pristinesource/0ZeroRobotControl/pics/PiPrinter005.png

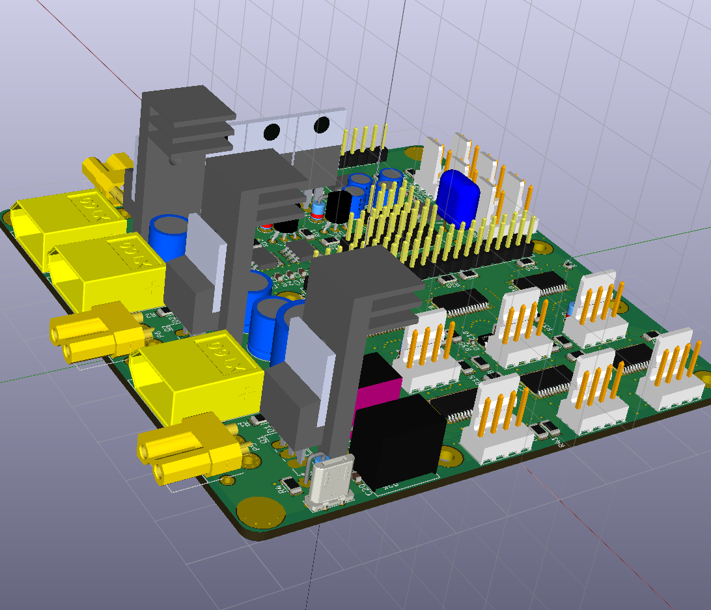
pics/PiPrinter005.png
