pristinesource/0ZeroRobotControl/pics/PiPrinter001.png

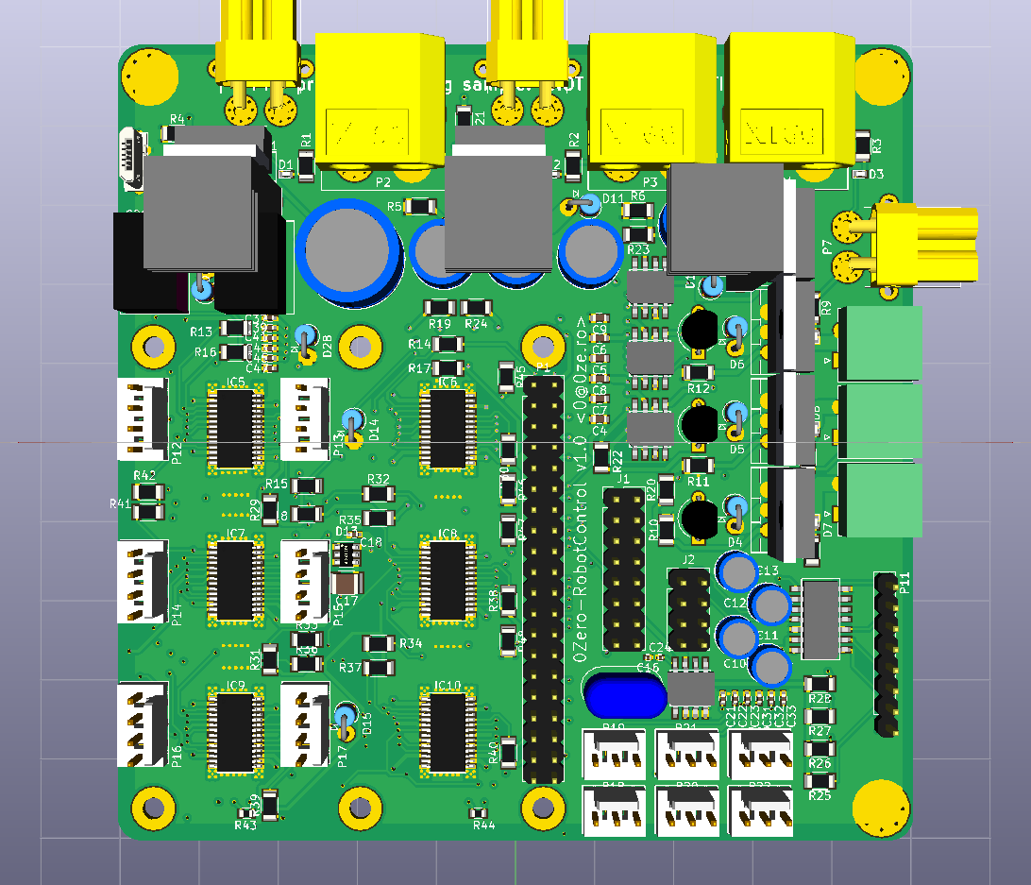
pics/PiPrinter001.png
