pristinesource/0ZeroRobotControl/0ZeroRobotControl_BOM.xlsx

Title
Revision
Date
Generated | 2017-03-08 17:09
Company
Comment 1
Comment 2
Comment 3
Comment 4
Total Parts | 155
Total Unique Parts | 56
Ref | Qty | Value | Footprint | Price per 1 |  | Price per 1000 |  | Digi-key Product Link | Alt Product Link
C2 C3 C14 C15 | 4 | 100uF | Capacitors_THT:CP_Radial_D8.0mm_P3.50mm | $0.58 | $2.32 | $148.24 | $592.96 | http://www.digikey.com/short/329c5t | http://www.digikey.com/short/329c58
C4 C5 C6 C9 C8 C7 C20 | 7 | .1uF | Capacitors_SMD:C_0603 | $0.10 | $0.70 | $6.24 | $43.68 | http://www.digikey.com/short/329cw3
C10 C11 C12 C13 | 4 | 10uF | Capacitors_THT:CP_Radial_D5.0mm_P2.00mm | $0.26 | $1.04 | $53.82 | $215.28 | http://www.digikey.com/short/329c11
C1 | 1 | 680 uF | Capacitors_THT:CP_Radial_D12.5mm_P5.00mm | $1.31 | $1.31 | $518.10 | $518.10 | http://www.digikey.com/short/329c0t
C37 C39 C41 C43 C45 C47 C17 C18 C19 C28 C29 C30 | 12 | 220 nF | Capacitors_SMD:C_0402 | $0.22 | $2.64 | $46.76 | $561.12 | http://www.digikey.com/short/32bp2q
C25 C21 C26 C22 C27 C23 C34 C31 C35 C32 C36 C33 | 12 | 10 nF | Capacitors_SMD:C_0402 | $0.10 | $1.20 | $7.03 | $84.36 | http://www.digikey.com/short/32bpwm
C16 C24 | 2 | 27 pF | Capacitors_SMD:C_0201 | $0.10 | $0.20 | $3.64 | $7.28 | http://www.digikey.com/short/32bpnm
D2 | 1 | LED2 | LEDs:LED_0402 | $0.42 | $0.42 | $110.88 | $110.88 | http://www.digikey.com/short/32bpv5 | Red
D1 | 1 | LED1 | LEDs:LED_0402 | $0.42 | $0.42 | $110.88 | $110.88 | http://www.digikey.com/short/32bpv5 | Red
D3 | 1 | LED3 | LEDs:LED_0402 | $0.42 | $0.42 | $110.88 | $110.88 | http://www.digikey.com/short/32bpv5 | Red
D8 | 1 | LED5 | LEDs:LED_0402 | $0.42 | $0.42 | $110.88 | $110.88 | http://www.digikey.com/short/32bp1q | Yellow
D7 | 1 | LED4 | LEDs:LED_0402 | $0.42 | $0.42 | $110.88 | $110.88 | http://www.digikey.com/short/32bp1q | Yellow
D9 | 1 | LED6 | LEDs:LED_0402 | $0.42 | $0.42 | $110.88 | $110.88 | http://www.digikey.com/short/32bp1q | Yellow
D4 D5 D6 D10 D11 D12 D21 D24 | 8 | SB340 | Diodes_THT:D_T-1_P2.54mm_Vertical_AnodeUp | $0.44 | $3.52 | $222.54 | $1780.32 | http://www.digikey.com/short/32bzc8
D20 D22 D23 D25 D26 D27 | 6 | BAV99 | TO_SOT_Packages_SMD:SOT-23 | $0.21 | $1.26 | $39.14 | $234.84 | http://www.digikey.com/short/32bzcn
D28 | 1 | 3.3V-3W | Diodes_THT:D_T-1_P2.54mm_Vertical_AnodeUp | $0.36 | $0.36 | $111.24 | $111.24 | http://www.digikey.com/short/32bz7r
IC1 IC2 IC3 | 3 | TC4427A | SMD_Packages:SOIC-8-N | $1.17 | $3.51 | $885.80 | $2657.40 | http://www.digikey.com/short/32bztp
IC5 IC6 IC7 IC8 IC9 IC10 | 6 | L6470 | Housings_SSOP:HTSSOP-28_4.4x9.7mm_Pitch0.65mm_ThermalPad | $7.72 | $46.32 | $4378.05 | $26268.30 | http://www.digikey.com/short/32bz30
IC4 | 1 | CY25811 | SMD_Packages:SOIC-8-N | $2.20 | $2.20 | $1123.38 | $1123.38 | http://www.digikey.com/short/32bz84
J1 | 1 | CONN_02X08 | Pin_Headers:Pin_Header_Straight_2x08_Pitch2.54mm | $0.61 | $0.61 | $313.01 | $313.01 | http://www.digikey.com/short/32bz59
J2 | 1 | CONN_02X03 | Pin_Headers:Pin_Header_Straight_2x04_Pitch2.54mm | $0.36 | $0.36 | $168.00 | $168.00 | http://www.digikey.com/short/32bzr0
P1 | 1 | RaspPi 40pin Conn | Pin_Headers:Pin_Header_Straight_2x20_Pitch2.54mm | $5.10 | $5.10 | $5100.00 | $5100.00 | http://www.digikey.com/short/32htp8 | http://www.digikey.com/short/32htzq
P8 P9 P10 | 3 | 5452027 | Connectors_Phoenix:PhoenixContact_MC-G_02x3.81mm_Angled | $0.76 | $2.28 | $534.60 | $1603.80 | http://www.digikey.com/short/32bz2h
P7 P6 P5 | 3 | XT30PW-F | PiPrinter:XT30PW-F2 | $1.00 | $3.00 | $1000.00 | $3000.00 | http://www.banggood.com/5Pairs-Amass-XT30PW-30A-Low-Temperature-Rise-Fire-Retardant-Plug-p-1075324.html | http://www.china-amass.com/ChanPinZhanShi_v212.html
P2 P3 P4 | 3 | XT60PW-M | PiPrinter:XT60PW | $0.80 | $2.40 | $800.00 | $2400.00 | http://www.banggood.com/5X-Amass-XT60PW-Plug-Connector-Male-Female-For-RC-Battery-p-1081485.html?rmmds=search | http://www.china-amass.com/ChanPinZhanShi_v219.html
P11 | 1 | Thermistor_Inputs | Pin_Headers:Pin_Header_Straight_1x08_Pitch2.54mm | $0.26 | $0.26 | $131.29 | $131.29 | http://www.digikey.com/short/32b4c3
P18 | 1 | SW1 | Connectors_Molex:Molex_KK-6410-03_03x2.54mm_Straight | $0.35 | $0.35 | $167.13 | $167.13 | http://www.digikey.com/short/32bzv1
P19 | 1 | SW2 | Connectors_Molex:Molex_KK-6410-03_03x2.54mm_Straight | $0.35 | $0.35 | $167.13 | $167.13 | http://www.digikey.com/short/32bzv1
P20 | 1 | SW3 | Connectors_Molex:Molex_KK-6410-03_03x2.54mm_Straight | $0.35 | $0.35 | $167.13 | $167.13 | http://www.digikey.com/short/32bzv1
P21 | 1 | SW4 | Connectors_Molex:Molex_KK-6410-03_03x2.54mm_Straight | $0.35 | $0.35 | $167.13 | $167.13 | http://www.digikey.com/short/32bzv1
P22 | 1 | SW5 | Connectors_Molex:Molex_KK-6410-03_03x2.54mm_Straight | $0.35 | $0.35 | $167.13 | $167.13 | http://www.digikey.com/short/32bzv1
P23 | 1 | SW6 | Connectors_Molex:Molex_KK-6410-03_03x2.54mm_Straight | $0.35 | $0.35 | $167.13 | $167.13 | http://www.digikey.com/short/32bzv1
P25 P26 | 2 | CONN_01X01 | Pin_Headers:Pin_Header_Straight_1x01_Pitch2.54mm | $0.10 | $0.20 | $27.95 | $55.90 | http://www.digikey.com/short/32b47r
P12 | 1 | MOTOR-1 | Connectors_Molex:Molex_KK-6410-04_04x2.54mm_Straight | $0.39 | $0.39 | $182.35 | $182.35 | http://www.digikey.com/short/32b43q
P13 | 1 | MOTOR-2 | Connectors_Molex:Molex_KK-6410-04_04x2.54mm_Straight | $0.39 | $0.39 | $182.35 | $182.35 | http://www.digikey.com/short/32b43q
P14 | 1 | MOTOR-3 | Connectors_Molex:Molex_KK-6410-04_04x2.54mm_Straight | $0.39 | $0.39 | $182.35 | $182.35 | http://www.digikey.com/short/32b43q
P15 | 1 | MOTOR-4 | Connectors_Molex:Molex_KK-6410-04_04x2.54mm_Straight | $0.39 | $0.39 | $182.35 | $182.35 | http://www.digikey.com/short/32b43q
P16 | 1 | MOTOR-5 | Connectors_Molex:Molex_KK-6410-04_04x2.54mm_Straight | $0.39 | $0.39 | $182.35 | $182.35 | http://www.digikey.com/short/32b43q
P17 | 1 | MOTOR-6 | Connectors_Molex:Molex_KK-6410-04_04x2.54mm_Straight | $0.39 | $0.39 | $182.35 | $182.35 | http://www.digikey.com/short/32b43q
Q2 Q1 Q3 | 3 | AOT240L | TO_SOT_Packages_THT:TO-220_Neutral123_Vertical_LargePads | $1.63 | $4.89 | $761.25 | $2283.75 | http://www.digikey.com/short/32b48t
Q5 Q4 Q6 | 3 | AOT2618L | TO_SOT_Packages_THT:TO-220_Neutral123_Vertical_LargePads | $0.95 | $2.85 | $405.00 | $1215.00 | http://www.digikey.com/short/32b48z
R2 R1 R3 R8 R7 R9 | 6 | 8.2K | Resistors_SMD:R_1206 | $0.10 | $0.60 | $19.80 | $118.80 | http://www.digikey.com/short/32b4bc
R5 R4 R6 R11 R10 R12 | 6 | 10K | Resistors_SMD:R_1206 | $0.10 | $0.60 | $9.04 | $54.24 | http://www.digikey.com/short/32b4bd
R19 R20 R21 R22 R23 R24 | 6 | 22R | Resistors_SMD:R_1206 | $0.14 | $0.84 | $19.80 | $118.80 | http://www.digikey.com/short/32b45n
R25 R26 R27 R28 | 4 | 4.7K | Resistors_SMD:R_1206 | $0.14 | $0.56 | $19.80 | $79.20 | http://www.digikey.com/short/32b4r5
R13 R14 R15 R32 R33 R34 | 6 | 100R | Resistors_SMD:R_1206 | $0.10 | $0.60 | $9.08 | $54.48 | http://www.digikey.com/short/32b4f7
R29 R16 R30 R17 R31 R18 R38 R35 R39 R36 R40 R37 | 12 | 39K | Resistors_SMD:R_1206 | $0.14 | $1.68 | $19.80 | $237.60 | http://www.digikey.com/short/32b4f2
R41 | 1 | 36K | Resistors_SMD:R_1206 | $0.14 | $0.14 | $19.80 | $19.80 | http://www.digikey.com/short/32b4wc
R42 | 1 | 2.7K | Resistors_SMD:R_1206 | $0.14 | $0.14 | $19.80 | $19.80 | http://www.digikey.com/short/32b4ww
U1 U2 U3 | 3 | LM78L12ACZ | TO_SOT_Packages_THT:TO-92_Inline_Wide | $0.44 | $1.32 | $109.60 | $328.80 | http://www.digikey.com/short/32b4hm
U8 | 1 | R-78E5.0-1.0 | PiPrinter:R-78E5.0-1.0 | $3.62 | $3.62 | $2898.00 | $2898.00 | http://www.digikey.com/short/32b4mr
U7 | 1 | R-78E3.3-1.0 | PiPrinter:R-78E3.3-1.0 | $3.62 | $3.62 | $2898.00 | $2898.00 | http://www.digikey.com/short/32b4m3
U4 | 1 | MCP3204 | SMD_Packages:SOIC-14_N | $3.27 | $3.27 | $2472.00 | $2472.00 | http://www.digikey.com/short/32b44z
Y1 | 1 | Crystal 32MHz | Crystals:Resonator-2pin_w10.0mm_h5.0mm | $0.39 | $0.39 | $208.00 | $208.00 | http://www.digikey.com/short/32b4pf
 | 3 | TO-220 Heatsink | CSM221-12AE-ND | $0.63 | $1.89 | $435.00 | $1305.00 | http://www.digikey.com/short/329jp4
 | 1 | USB Micro-B Plug | USB3150-30-075-A | $0.99 | $0.99 | $485.00 | $485.00 | http://www.newark.com/global-connector-technology/usb3150-30-075-a/micro-usb-2-0-type-b-plug-th/dp/49Y1722
 | 159 |  | TOTALS: | $47.26 | $115.75 | $29189.76 | $64528.69
BOM made with KICAD_BOM_WIZARD (https://github.com/HashDefineElectronics/KiCad_BOM_Wizard.git)
Generated 3/8/2017 5:09:55 PM |  |  |  | PCBs | 60 | http://dirtypcbs.com/store/pcbs
 |  |  |  | Stencil | 50 | http://www.stencilsunlimited.com/stainless-steel-smt-stencil-p-727.html
 |  |  |  | solder paste | 50 | http://www.stencilsunlimited.com/nc676-no-clean-solder-paste-p-599.html
 |  |  |  | squegee | 10 | http://www.stencilsunlimited.com/prototype-squeegee-blade-p-79.html
