pristinesource/0ZeroRobotControl/BOM.xlsx

description | part group | preferred part number | alt part number | product page | qty req | extended desc.
MOSFET Driver | MOSFET Power | TC4427AEPA | TC4427ACPA | http://www.digikey.com/product-detail/en/microchip-technology/TC4427AEPA/TC4427AEPA-ND/442808 http://www.digikey.com/product-detail/en/microchip-technology/TC4427ACPA/TC4427ACPA-ND/418665 | 3
Large MOSFET | MOSFET Power | AOT240L |  | http://www.digikey.com/short/3f8954 | 3
Small MOSFET | MOSFET Power | AOT2618L |  | http://www.digikey.com/short/3f82zp | 3
to-220 mosfet heatsinks | MOSFET Power | 574502B03700G | 574602B03700G | http://www.digikey.com/product-detail/en/aavid-thermalloy/574502B03700G/HS358-ND/1216363 http://www.digikey.com/product-detail/en/aavid-thermalloy/574602B03700G/HS359-ND/1216364 | 6
external power input | MOSFET Power | XT60PW-M |  |  | 3
external power outputs for big MOSFETS | MOSFET Power | XT30PW-F |  |  | 3
external power outputs for small MOSFETS | MOSFET Power | 5452027 - Phoenix Contact |  | http://www.digikey.com/short/3fjc2b http://www.digikey.com/short/3fjcnt http://www.digikey.com/short/3fjc0b http://www.digikey.com/short/328311 | 3 | 2 Position Terminal Block Header, Male Pins, Shrouded (4 Side) 0.150" (3.81mm) 90°, Right Angle Through Hole
12v power regulator for MOSFET driver | MOSFET Power | LM78L12ACZX |  | http://www.digikey.com/short/3f8b79 | 3
Resistors 10K | MOSFET Power | 10K |  |  | 12
Resistors 8.2K | MOSFET Power | 8.2k |  |  | 6
Resistors 22R | MOSFET Power | 22R |  |  | 6
Status LEDs | MOSFET Power | not sure yet |  |  | 6 | 3 one color for small, and 3 a diff color for lrg
Polarized Cpacitors | MOSFET Power | 100uF |  |  | 3
Non-Polorized Cpacitors | MOSFET Power | .1uF |  |  | 6
Diodes for small MOSFET flyback | MOSFET Power | SB340 |  | http://www.digikey.com/short/3fjrjm | 6
ADC | Temp ctrl | MCP3204-CI/P | https://www.adafruit.com/product/1083 | http://www.digikey.com/short/3fjn17 | 1 | https://learn.adafruit.com/reading-a-analog-in-and-controlling-audio-volume-with-the-raspberry-pi
Endstop Connectors | Endstops | WM10158-ND | 1718570003 - Molex | http://www.digikey.com/short/3fj07m | 6 | 3 Positions Header Connector 0.100" (2.54mm) Through Hole, Right Angle Tin
Stepper motor connectors | Steppers | WM10159-ND | 1718570004 - Molex | http://www.digikey.com/short/3fj03r | 5
 |  | IO Expander | MCP23S08-E/P-ND | MCP23S08-E/P | 1 | I/O Expander 8 SPI 10MHz 18-PDIP | https://learn.adafruit.com/mcp230xx-gpio-expander-on-the-raspberry-pi/overview
