pristinesource/0ZeroRobotControl/pics/PiPrinter002.png

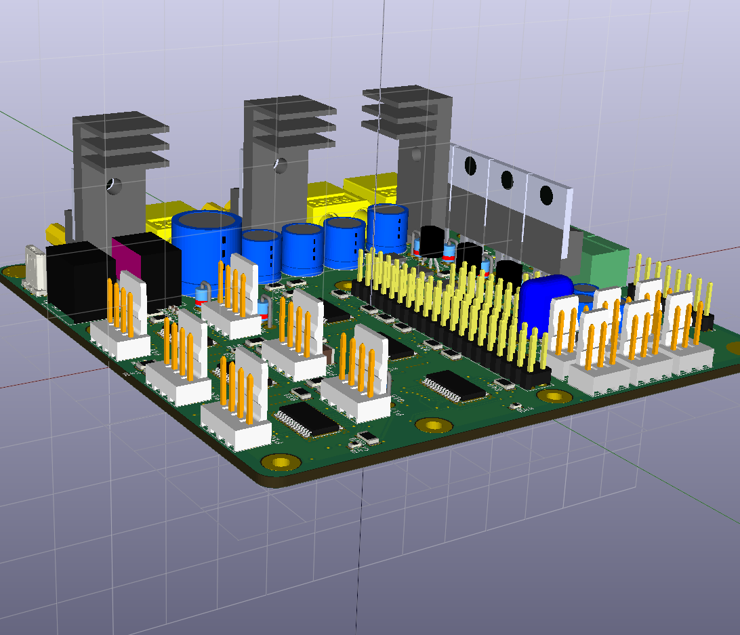
pics/PiPrinter002.png
