pristinesource/0ZeroRobotControl/pics/PiPrinter003.png

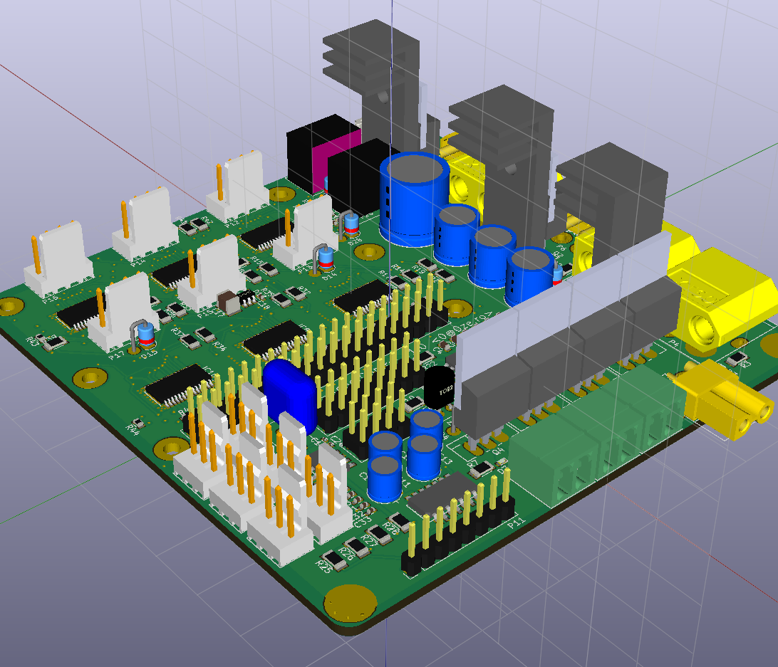
pics/PiPrinter003.png
