pristinesource/0ZeroRobotControl/pics/PiPrinter004.png

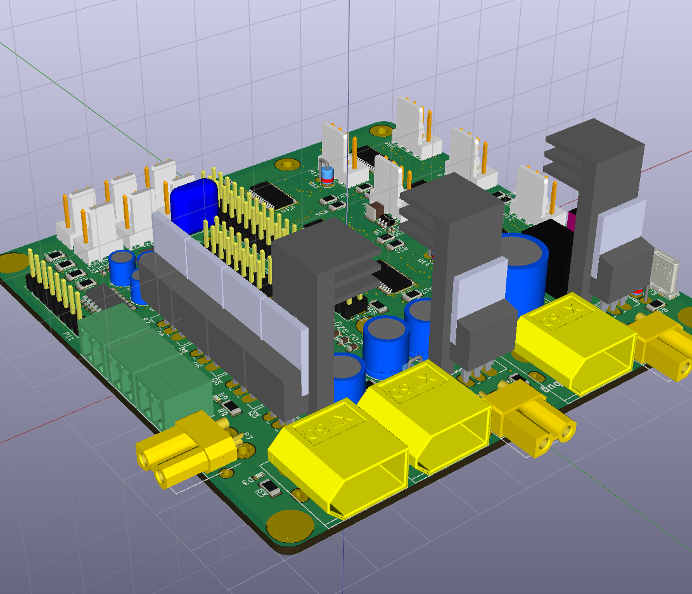
pics/PiPrinter004.png
