pristinesource/0ZeroRobotControl/pics/PiPrinter006.png

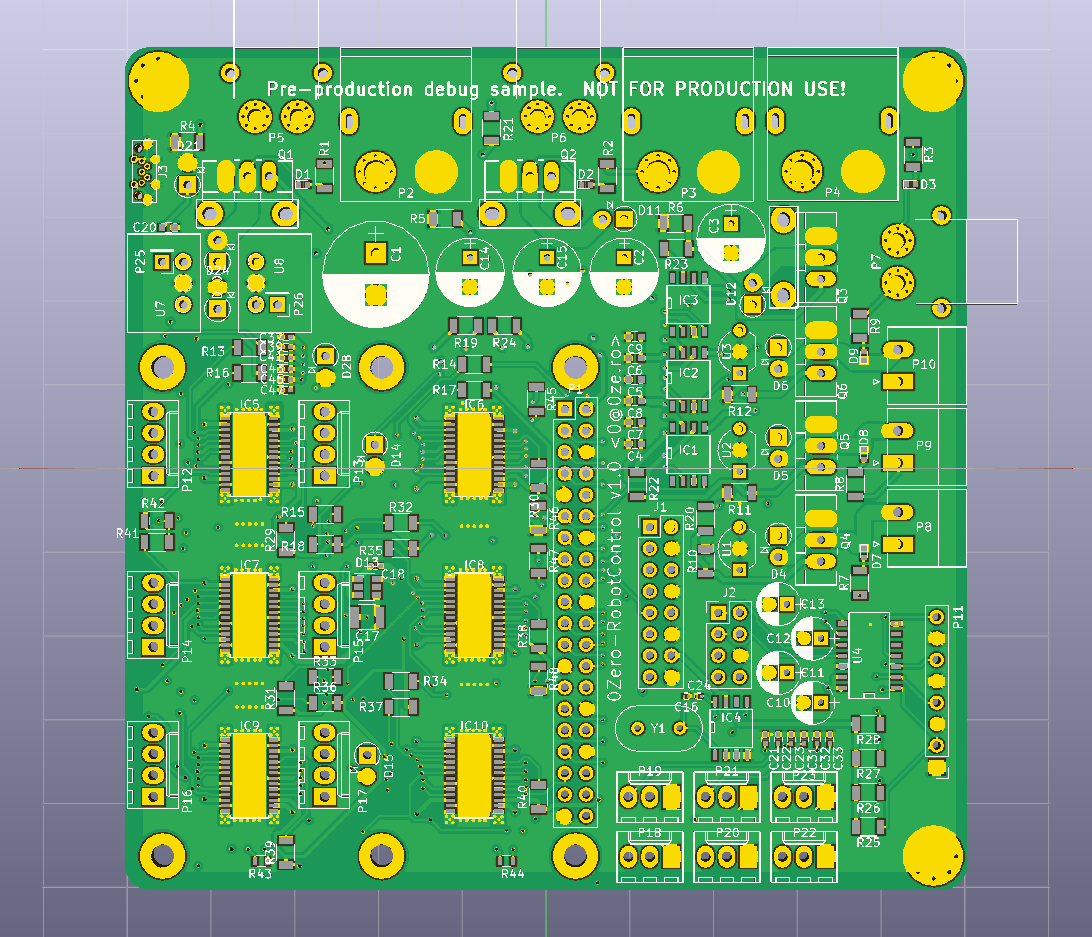
pics/PiPrinter006.png
