pristinesource/0ZeroRobotControl/(list of files, drawings)

Other design files:
0ZeroRobotControl.dsn
