pristinesource/0ZeroRobotControl/0ZeroRobotControl.sch

## KiCad design 0ZeroRobotControl.sch (2017-04-07)

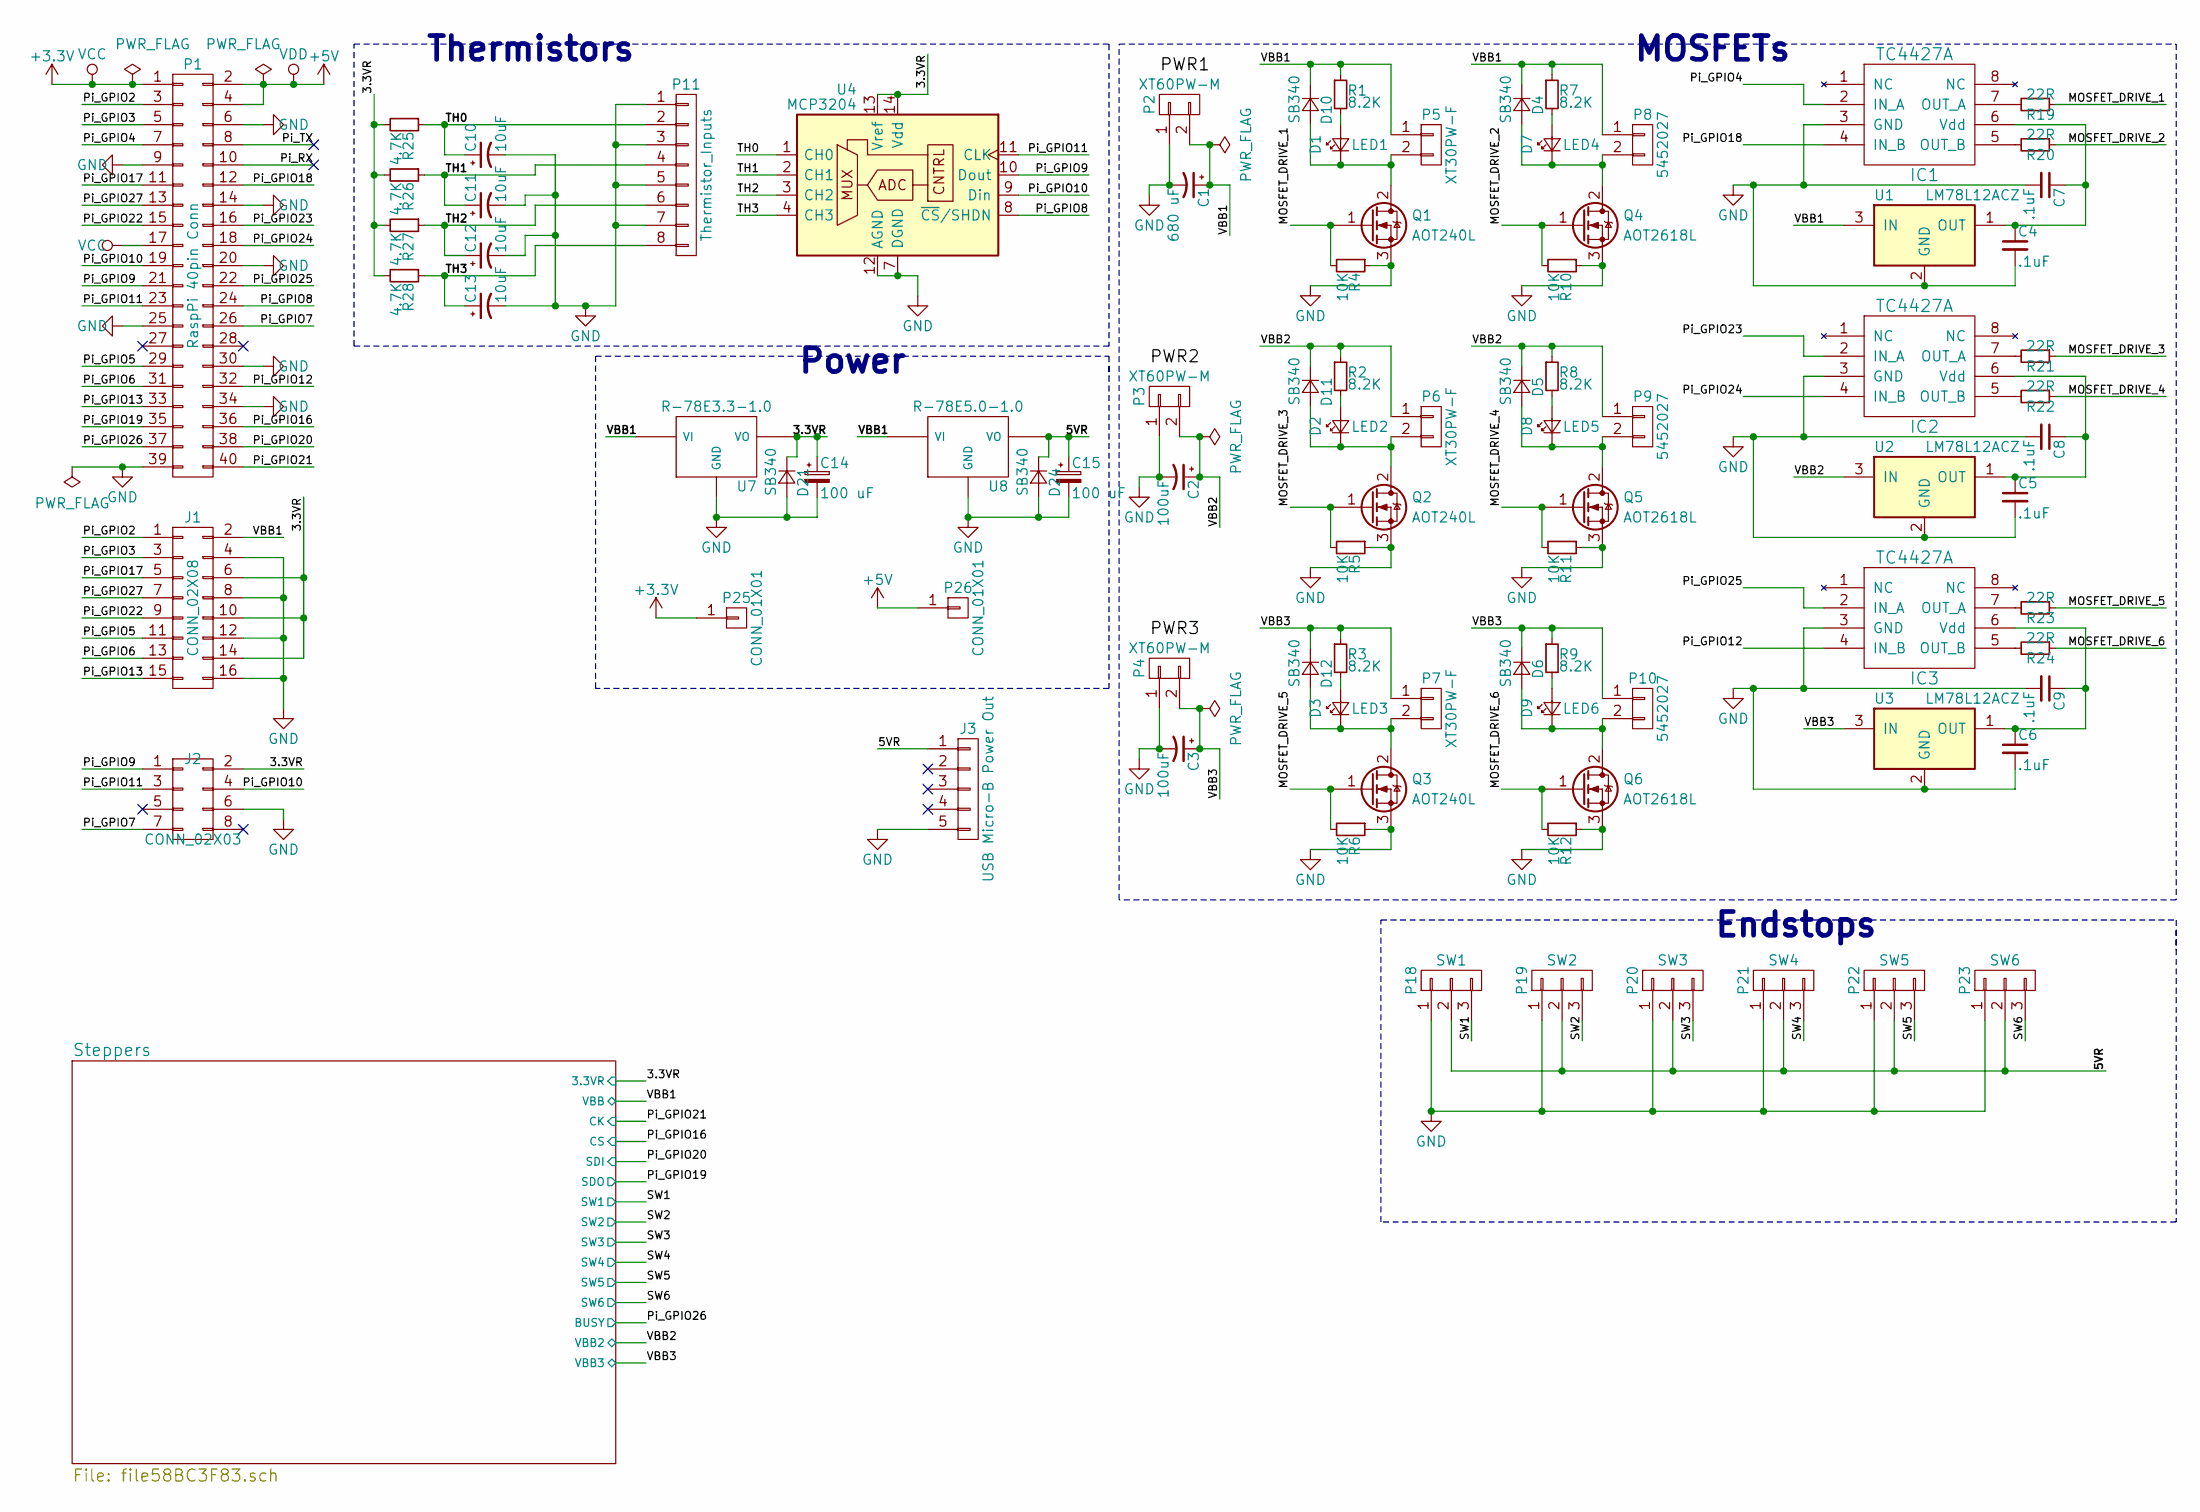
[picture p7: schematic 0ZeroRobotControl.sch]

Parts:
C1: 680 uF; CP_Radial_D12.5mm_P5.00mm
C2, C3: 100uF; CP_Radial_D8.0mm_P3.50mm
C4, C5, C6, C7, C8, C9: .1uF; C_0603
C10, C11, C12, C13: 10uF; CP_Radial_D5.0mm_P2.00mm
C14, C15: 100 uF; CP_Radial_D8.0mm_P3.50mm
D1: LED1; LED_0402
D2: LED2; LED_0402
D3: LED3; LED_0402
D4, D5, D6, D10, D11, D12, D21, D24: SB340; D_T-1_P2.54mm_Vertical_AnodeUp
D7: LED4; LED_0402
D8: LED5; LED_0402
D9: LED6; LED_0402
IC1, IC2, IC3: TC4427A; SOIC-8-N
J1: CONN_02X08; Pin_Header_Straight_2x08_Pitch2.54mm
J2: CONN_02X03; Pin_Header_Straight_2x04_Pitch2.54mm
J3: USB Micro-B Power Out; USB3150-30-075-A
P1: RaspPi 40pin Conn; Pin_Header_Straight_2x20_Pitch2.54mm
P2, P3, P4: XT60PW-M; XT60PW
P5, P6, P7: XT30PW-F; XT30PW-F2
P8, P9, P10: 5452027; PhoenixContact_MC-G_02x3.81mm_Angled
P11: Thermistor_Inputs; Pin_Header_Straight_1x08_Pitch2.54mm
P18: SW1; Molex_KK-6410-03_03x2.54mm_Straight
P19: SW2; Molex_KK-6410-03_03x2.54mm_Straight
P20: SW3; Molex_KK-6410-03_03x2.54mm_Straight
P21: SW4; Molex_KK-6410-03_03x2.54mm_Straight
P22: SW5; Molex_KK-6410-03_03x2.54mm_Straight
P23: SW6; Molex_KK-6410-03_03x2.54mm_Straight
P25, P26: CONN_01X01; Pin_Header_Straight_1x01_Pitch2.54mm
Q1, Q2, Q3: AOT240L; TO-220_Neutral123_Vertical_LargePads_plus_ohmite_heatsink
Q4, Q5, Q6: AOT2618L; TO-220_Neutral123_Vertical_LargePads
R1, R2, R3, R7, R8, R9: 8.2K; R_1206
R4, R5, R6, R10, R11, R12: 10K; R_1206
R19, R20, R21, R22, R23, R24: 22R; R_1206
R25, R26, R27, R28: 4.7K; R_1206
U1, U2, U3: LM78L12ACZ; TO-92_Inline_Wide
U4: MCP3204; SOIC-14_N
U7: R-78E3.3-1.0
U8: R-78E5.0-1.0

Connections:
3.3VR: C14.1, D21.1 (K), J1.6, J1.10, J1.14, J2.2, R25.2, R26.2, R27.2, R28.2, U4.13 (Vref), U4.14 (Vdd), U7.VO
5VR: C15.1, D24.1 (K), J3.1, P18.2, P19.2, P20.2, P21.2, P22.2, P23.2, U8.VO
+3.3V: P1.1, P1.17, P25.1
+5V: P1.2, P1.4, P26.1
GND: C1.2, C2.2, C3.2, C4.2, C5.2, C6.2, C7.2, C8.2, C9.2, C10.2, C11.2, C12.2, C13.2, C14.2, C15.2, D21.2 (A), D24.2 (A), IC1.3 (GND), IC2.3 (GND), IC3.3 (GND), J1.4, J1.8, J1.12, J1.16, J2.6, J3.5, P1.6, P1.9, P1.14, P1.20, P1.25, P1.30, P1.34, P1.39, P2.1, P3.1, P4.1, P11.1, P11.3, P11.5, P11.7, P18.1, P19.1, P20.1, P21.1, P22.1, P23.1, Q1.3 (S), Q2.3 (S), Q3.3 (S), Q4.3 (S), Q5.3 (S), Q6.3 (S), R4.1, R5.1, R6.1, R10.1, R11.1, R12.1, U1.2 (GND), U2.2 (GND), U3.2 (GND), U4.7 (DGND), U4.12 (AGND), U7.GND, U8.GND
MOSFET_DRIVE_1: Q1.1 (G), R4.2, R19.1
MOSFET_DRIVE_2: Q4.1 (G), R10.2, R20.1
MOSFET_DRIVE_3: Q2.1 (G), R5.2, R21.1
MOSFET_DRIVE_4: Q5.1 (G), R11.2, R22.1
MOSFET_DRIVE_5: Q3.1 (G), R6.2, R23.1
MOSFET_DRIVE_6: Q6.1 (G), R12.2, R24.1
unnamed: C4.1, C7.1, IC1.6 (Vdd), U1.1 (OUT)
unnamed: C5.1, C8.1, IC2.6 (Vdd), U2.1 (OUT)
unnamed: C6.1, C9.1, IC3.6 (Vdd), U3.1 (OUT)
unnamed: D1.1 (K), D10.2 (A), P5.2, Q1.2 (D)
unnamed: D1.2 (A), R1.2
unnamed: D2.2 (A), R2.2
unnamed: D3.2 (A), R3.2
unnamed: D4.2 (A), D7.1 (K), P8.2, Q4.2 (D)
unnamed: D5.2 (A), D8.1 (K), P9.2, Q5.2 (D)
unnamed: D6.2 (A), D9.1 (K), P10.2, Q6.2 (D)
unnamed: D7.2 (A), R7.2
unnamed: D8.2 (A), R8.2
unnamed: D9.2 (A), R9.2
unnamed: D2.1 (K), D11.2 (A), P6.2, Q2.2 (D)
unnamed: D3.1 (K), D12.2 (A), P7.2, Q3.2 (D)
unnamed: IC1.5 (OUT_B), R20.2
unnamed: IC1.7 (OUT_A), R19.2
unnamed: IC2.5 (OUT_B), R22.2
unnamed: IC2.7 (OUT_A), R21.2
unnamed: IC3.5 (OUT_B), R24.2
unnamed: IC3.7 (OUT_A), R23.2
Pi_GPIO2: J1.1, P1.3
Pi_GPIO3: J1.3, P1.5
Pi_GPIO4: IC1.2 (IN_A), P1.7
Pi_GPIO5: J1.11, P1.29
Pi_GPIO6: J1.13, P1.31
Pi_GPIO7: J2.7, P1.26
Pi_GPIO8: P1.24, U4.8 (~CS~/SHDN)
Pi_GPIO9: J2.1, P1.21, U4.10 (Dout)
Pi_GPIO10: J2.4, P1.19, U4.9 (Din)
Pi_GPIO11: J2.3, P1.23, U4.11 (CLK)
Pi_GPIO12: IC3.4 (IN_B), P1.32
Pi_GPIO13: J1.15, P1.33
Pi_GPIO16: P1.36
Pi_GPIO17: J1.5, P1.11
Pi_GPIO18: IC1.4 (IN_B), P1.12
Pi_GPIO19: P1.35
Pi_GPIO20: P1.38
Pi_GPIO21: P1.40
Pi_GPIO22: J1.9, P1.15
Pi_GPIO23: IC2.2 (IN_A), P1.16
Pi_GPIO24: IC2.4 (IN_B), P1.18
Pi_GPIO25: IC3.2 (IN_A), P1.22
Pi_GPIO26: P1.37
Pi_GPIO27: J1.7, P1.13
Pi_RX: P1.10
Pi_TX: P1.8
SW1: P18.3
SW2: P19.3
SW3: P20.3
SW4: P21.3
SW5: P22.3
SW6: P23.3
TH0: C10.1, P11.2, R25.1, U4.1 (CH0)
TH1: C11.1, P11.4, R26.1, U4.2 (CH1)
TH2: C12.1, P11.6, R27.1, U4.3 (CH2)
TH3: C13.1, P11.8, R28.1, U4.4 (CH3)
VBB1: C1.1, D4.1 (K), D10.1 (K), J1.2, P2.2, P5.1, P8.1, R1.1, R7.1, U1.3 (IN), U7.VI, U8.VI
VBB2: C2.1, D5.1 (K), D11.1 (K), P3.2, P6.1, P9.1, R2.1, R8.1, U2.3 (IN)
VBB3: C3.1, D6.1 (K), D12.1 (K), P4.2, P7.1, P10.1, R3.1, R9.1, U3.3 (IN)

Notes on the sheet:
MOSFETs
Thermistors
Endstops
Power
