pristinesource/0ZeroRobotControl/file58BC3F83.sch

## KiCad design file58BC3F83.sch (2017-04-07)

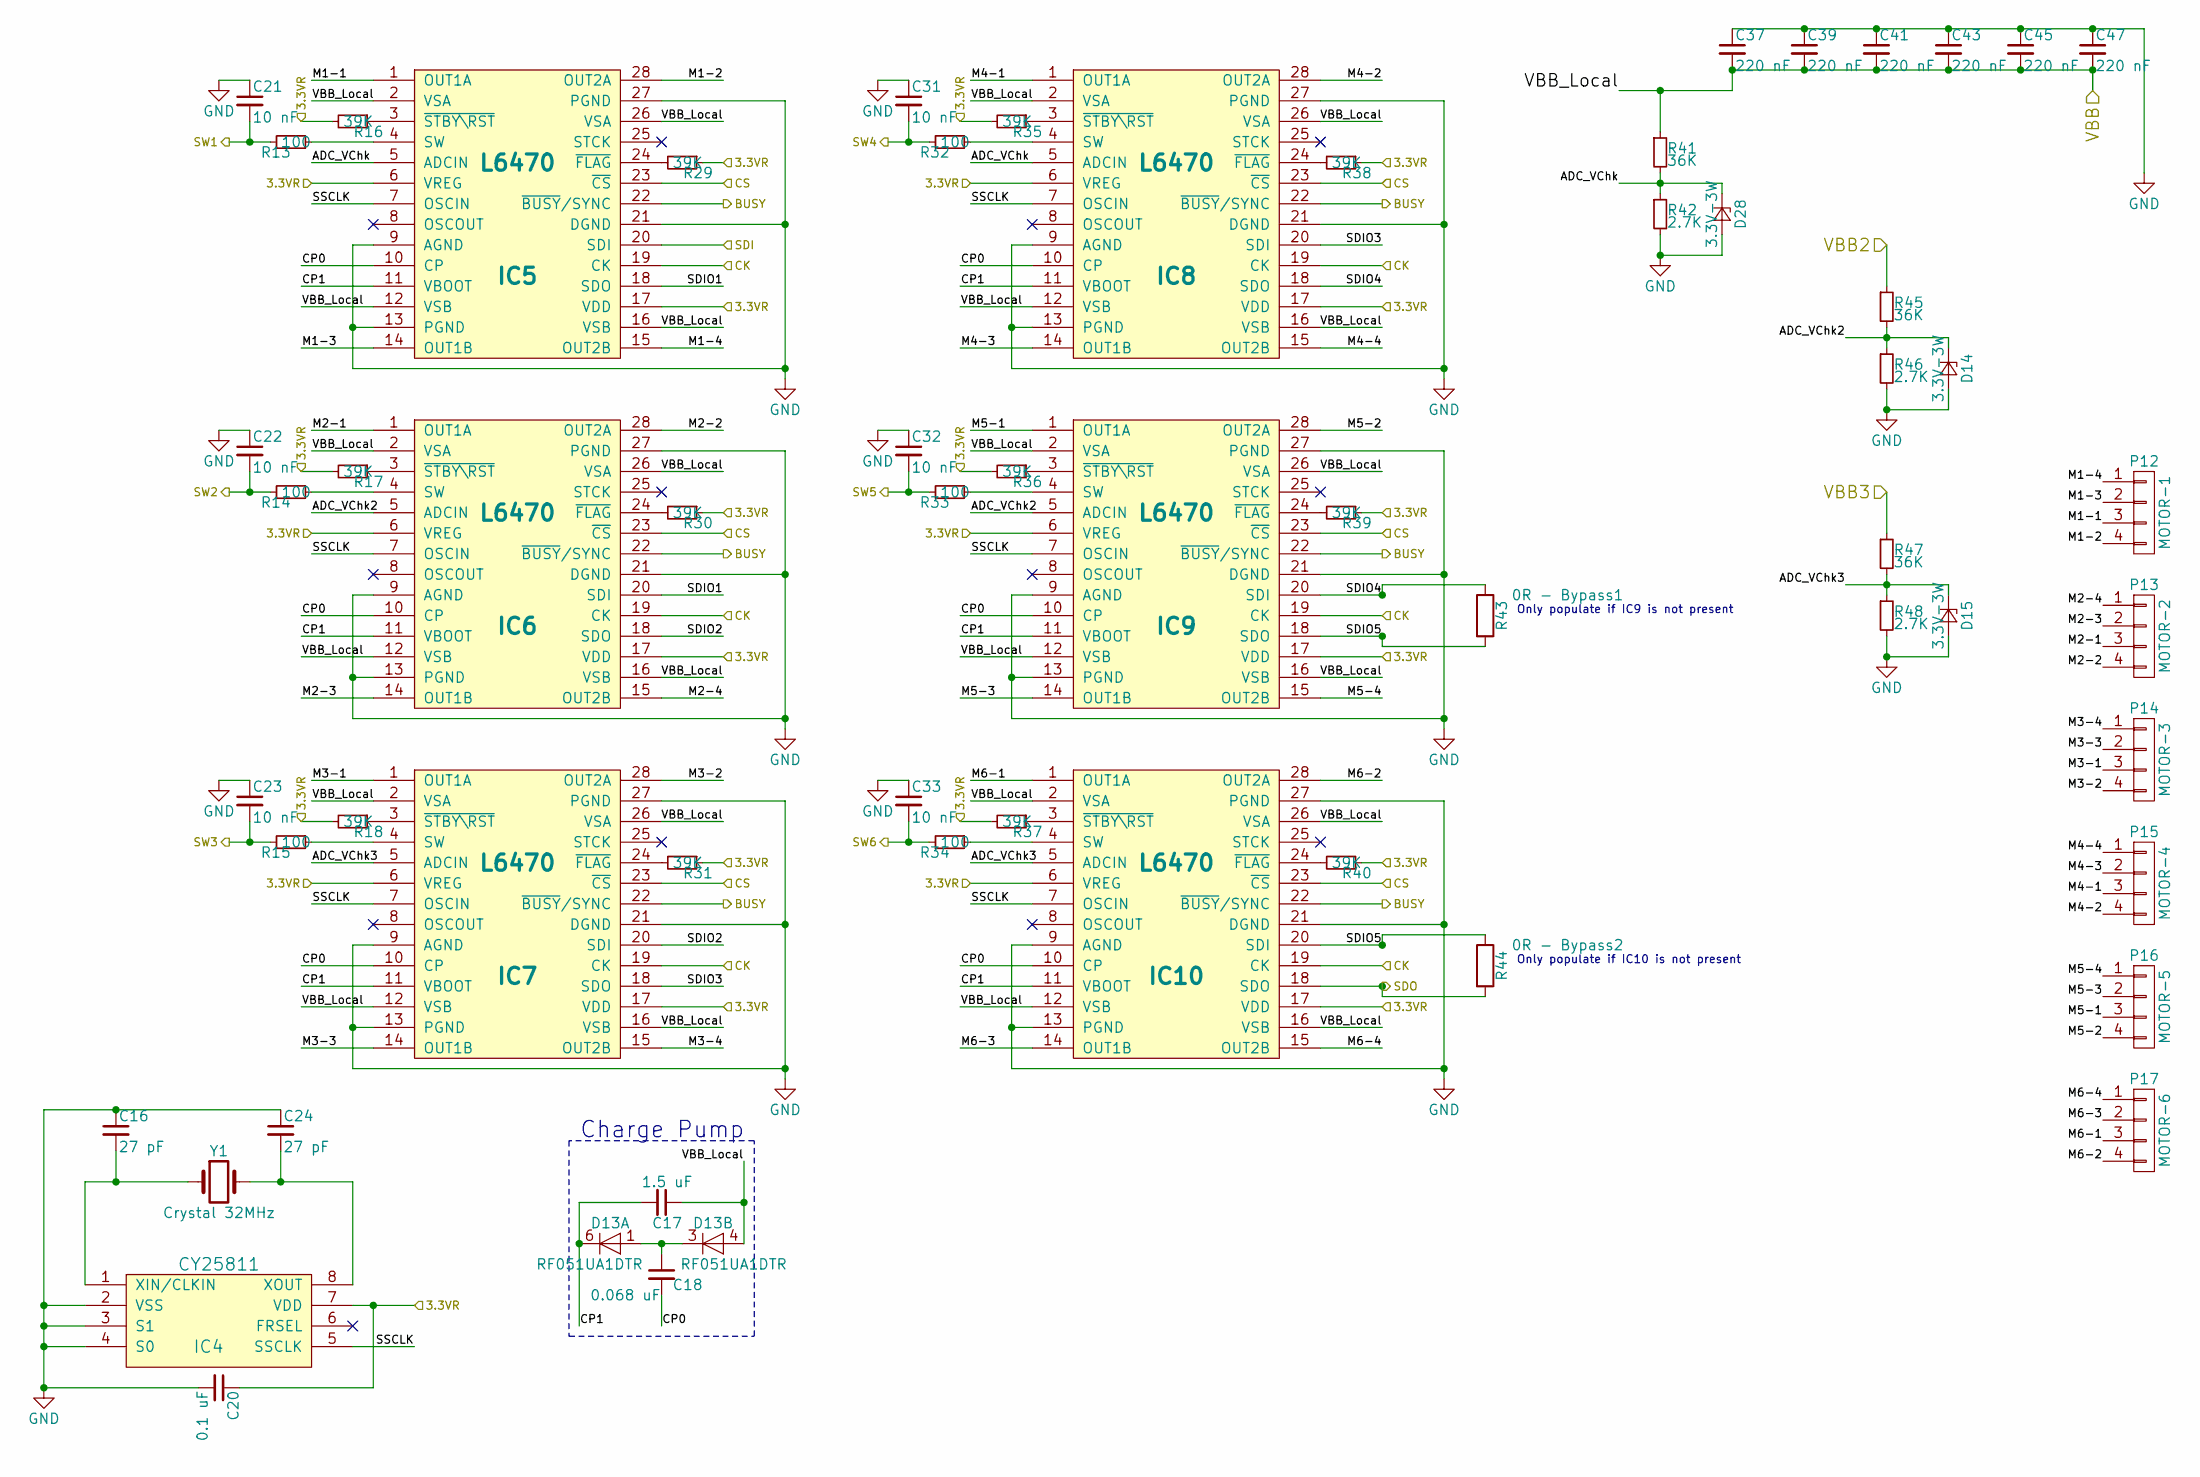
[picture p8: schematic file58BC3F83.sch]

Parts:
C16, C24: 27 pF; C_0201
C17: 1.5 uF; C_1210
C18: 0.068 uF; C_0402
C20: 0.1 uF; C_0603
C21, C22, C23, C31, C32, C33: 10 nF; C_0402
C37, C39, C41, C43, C45, C47: 220 nF; C_0402
D13: RF051UA1DTR; SOT-23-6
D14, D15, D28: 3.3V-3W; D_T-1_P2.54mm_Vertical_AnodeUp
IC4: CY25811; SOIC-8-N
IC5, IC6, IC7, IC8, IC9, IC10: L6470; HTSSOP-28_4.4x9.7mm_Pitch0.65mm_ThermalPad
P12: MOTOR-1; Molex_KK-6410-04_04x2.54mm_Straight
P13: MOTOR-2; Molex_KK-6410-04_04x2.54mm_Straight
P14: MOTOR-3; Molex_KK-6410-04_04x2.54mm_Straight
P15: MOTOR-4; Molex_KK-6410-04_04x2.54mm_Straight
P16: MOTOR-5; Molex_KK-6410-04_04x2.54mm_Straight
P17: MOTOR-6; Molex_KK-6410-04_04x2.54mm_Straight
R13, R14, R15, R32, R33, R34: 100; R_1206
R16, R17, R18, R29, R30, R31, R35, R36, R37, R38, R39, R40: 39K; R_1206
R41, R45, R47: 36K; R_1206
R42, R46, R48: 2.7K; R_1206
R43: 0R - Bypass1; R_0603
R44: 0R - Bypass2; R_0603
Y1: Crystal 32MHz; Resonator-2pin_w10.0mm_h5.0mm

Connections:
3.3VR: C20.1, IC4.7 (VDD), IC5.6 (VREG), IC5.17 (VDD), IC6.6 (VREG), IC6.17 (VDD), IC7.6 (VREG), IC7.17 (VDD), IC8.6 (VREG), IC8.17 (VDD), IC9.6 (VREG), IC9.17 (VDD), IC10.6 (VREG), IC10.17 (VDD), R16.2, R17.2, R18.2, R29.1, R30.1, R31.1, R35.2, R36.2, R37.2, R38.1, R39.1, R40.1
ADC_VChk: D28.1 (K), IC5.5 (ADCIN), IC8.5 (ADCIN), R41.2, R42.1
ADC_VChk2: D14.1 (K), IC6.5 (ADCIN), IC9.5 (ADCIN), R45.2, R46.1
ADC_VChk3: D15.1 (K), IC7.5 (ADCIN), IC10.5 (ADCIN), R47.2, R48.1
BUSY: IC5.22 (~BUSY~/SYNC), IC6.22 (~BUSY~/SYNC), IC7.22 (~BUSY~/SYNC), IC8.22 (~BUSY~/SYNC), IC9.22 (~BUSY~/SYNC), IC10.22 (~BUSY~/SYNC)
CK: IC5.19 (CK), IC6.19 (CK), IC7.19 (CK), IC8.19 (CK), IC9.19 (CK), IC10.19 (CK)
CP0: C18.2, IC5.10 (CP), IC6.10 (CP), IC7.10 (CP), IC8.10 (CP), IC9.10 (CP), IC10.10 (CP)
CP1: C17.2, D13.6 (K), IC5.11 (VBOOT), IC6.11 (VBOOT), IC7.11 (VBOOT), IC8.11 (VBOOT), IC9.11 (VBOOT), IC10.11 (VBOOT)
CS: IC5.23 (~CS), IC6.23 (~CS), IC7.23 (~CS), IC8.23 (~CS), IC9.23 (~CS), IC10.23 (~CS)
GND: C16.1, C20.2, C21.1, C22.1, C23.1, C24.1, C31.1, C32.1, C33.1, C37.1, C39.1, C41.1, C43.1, C45.1, C47.1, D14.2 (A), D15.2 (A), D28.2 (A), IC4.2 (VSS), IC4.3 (S1), IC4.4 (S0), IC5.9 (AGND), IC5.13 (PGND), IC5.21 (DGND), IC5.27 (PGND), IC6.9 (AGND), IC6.13 (PGND), IC6.21 (DGND), IC6.27 (PGND), IC7.9 (AGND), IC7.13 (PGND), IC7.21 (DGND), IC7.27 (PGND), IC8.9 (AGND), IC8.13 (PGND), IC8.21 (DGND), IC8.27 (PGND), IC9.9 (AGND), IC9.13 (PGND), IC9.21 (DGND), IC9.27 (PGND), IC10.9 (AGND), IC10.13 (PGND), IC10.21 (DGND), IC10.27 (PGND), R42.2, R46.2, R48.2
M1-1: IC5.1 (OUT1A), P12.3
M1-2: IC5.28 (OUT2A), P12.4
M1-3: IC5.14 (OUT1B), P12.2
M1-4: IC5.15 (OUT2B), P12.1
M2-1: IC6.1 (OUT1A), P13.3
M2-2: IC6.28 (OUT2A), P13.4
M2-3: IC6.14 (OUT1B), P13.2
M2-4: IC6.15 (OUT2B), P13.1
M3-1: IC7.1 (OUT1A), P14.3
M3-2: IC7.28 (OUT2A), P14.4
M3-3: IC7.14 (OUT1B), P14.2
M3-4: IC7.15 (OUT2B), P14.1
M4-1: IC8.1 (OUT1A), P15.3
M4-2: IC8.28 (OUT2A), P15.4
M4-3: IC8.14 (OUT1B), P15.2
M4-4: IC8.15 (OUT2B), P15.1
M5-1: IC9.1 (OUT1A), P16.3
M5-2: IC9.28 (OUT2A), P16.4
M5-3: IC9.14 (OUT1B), P16.2
M5-4: IC9.15 (OUT2B), P16.1
M6-1: IC10.1 (OUT1A), P17.3
M6-2: IC10.28 (OUT2A), P17.4
M6-3: IC10.14 (OUT1B), P17.2
M6-4: IC10.15 (OUT2B), P17.1
unnamed: C16.2, IC4.1 (XIN/CLKIN), Y1.1
unnamed: C18.1, D13.1 (A), D13.3 (K)
unnamed: C24.2, IC4.8 (XOUT), Y1.2
unnamed: IC5.3 (~STBY\RST), R16.1
unnamed: IC5.4 (SW), R13.1
unnamed: IC5.24 (~FLAG), R29.2
unnamed: IC6.3 (~STBY\RST), R17.1
unnamed: IC6.4 (SW), R14.1
unnamed: IC6.24 (~FLAG), R30.2
unnamed: IC7.3 (~STBY\RST), R18.1
unnamed: IC7.4 (SW), R15.1
unnamed: IC7.24 (~FLAG), R31.2
unnamed: IC8.3 (~STBY\RST), R35.1
unnamed: IC8.4 (SW), R32.1
unnamed: IC8.24 (~FLAG), R38.2
unnamed: IC9.3 (~STBY\RST), R36.1
unnamed: IC9.4 (SW), R33.1
unnamed: IC9.24 (~FLAG), R39.2
unnamed: IC10.3 (~STBY\RST), R37.1
unnamed: IC10.4 (SW), R34.1
unnamed: IC10.24 (~FLAG), R40.2
SDI: IC5.20 (SDI)
SDIO1: IC5.18 (SDO), IC6.20 (SDI)
SDIO2: IC6.18 (SDO), IC7.20 (SDI)
SDIO3: IC7.18 (SDO), IC8.20 (SDI)
SDIO4: IC8.18 (SDO), IC9.20 (SDI), R43.1
SDIO5: IC9.18 (SDO), IC10.20 (SDI), R43.2, R44.1
SDO: IC10.18 (SDO), R44.2
SSCLK: IC4.5 (SSCLK), IC5.7 (OSCIN), IC6.7 (OSCIN), IC7.7 (OSCIN), IC8.7 (OSCIN), IC9.7 (OSCIN), IC10.7 (OSCIN)
SW1: C21.2, R13.2
SW2: C22.2, R14.2
SW3: C23.2, R15.2
SW4: C31.2, R32.2
SW5: C32.2, R33.2
SW6: C33.2, R34.2
VBB: C17.1, C37.2, C39.2, C41.2, C43.2, C45.2, C47.2, D13.4 (A), IC5.2 (VSA), IC5.12 (VSB), IC5.16 (VSB), IC5.26 (VSA), IC6.2 (VSA), IC6.12 (VSB), IC6.16 (VSB), IC6.26 (VSA), IC7.2 (VSA), IC7.12 (VSB), IC7.16 (VSB), IC7.26 (VSA), IC8.2 (VSA), IC8.12 (VSB), IC8.16 (VSB), IC8.26 (VSA), IC9.2 (VSA), IC9.12 (VSB), IC9.16 (VSB), IC9.26 (VSA), IC10.2 (VSA), IC10.12 (VSB), IC10.16 (VSB), IC10.26 (VSA), R41.1
VBB2: R45.1
VBB3: R47.1

Notes on the sheet:
Only populate if IC9 is not present
Only populate if IC10 is not present
Charge Pump
